Sonalhegde/TEAM_DISTRO/DRIVE LINKS/README.md

# 🔗 Team DISTRO - Official Google Drive Links

This folder contains direct access links to the official media, presentation, documentation, and video deliverables for the **Lam Research Challenge 3.0: Stage 2 Practical Engineering Challenge (Team ID: LRC-26-0528)**.

---

## 📌 Deliverable Links

| # | Resource | Description | Direct Google Drive Link |
|---|---|---|---|
| 1 | 📊 **Team DISTRO Presentation** | Final presentation slide deck covering system design, hydraulics, calibration, and automation results | [Open Presentation Deck](https://drive.google.com/file/d/10BZNDP2cnqSBqfE3b11lk_6qCRlyOtN2/view?usp=drive_link) |
| 2 | 📄 **Stage 2 Challenge PDF** | Full practical engineering challenge documentation and report | [Open PDF Document](https://drive.google.com/file/d/1mI3886kun4H3olHrglMHzYJjbUjEaSkm/view?usp=drive_link) |
| 3 | 🎥 **Rig Journey Video** | Comprehensive video showcasing the rig assembly, testing, Case 1 surge mitigation, and Case 2 flushing automation | [Watch Journey Video](https://drive.google.com/file/d/1YkWeLo3Ct3zWrAMsbKcDU-8LQFBE7EN8/view?usp=drive_link) |

---

### Direct URL Reference List:
- **Presentation:** `https://drive.google.com/file/d/10BZNDP2cnqSBqfE3b11lk_6qCRlyOtN2/view?usp=drive_link`
- **PDF Documentation:** `https://drive.google.com/file/d/1mI3886kun4H3olHrglMHzYJjbUjEaSkm/view?usp=drive_link`
- **Journey Video:** `https://drive.google.com/file/d/1YkWeLo3Ct3zWrAMsbKcDU-8LQFBE7EN8/view?usp=drive_link`
