Sonalhegde/TEAM_DISTRO/TEAM.md

# Team Information

This document lists the members, roles, departments, and project contributions for Team DISTRO.

## Team Identification

- Team Identifier: LRC-26-0528
- Team Name: Team DISTRO
- Competition: Lam Research Challenge 3.0, Stage 2
- Institution: Nitte (Deemed to be University) - NMAM Institute of Technology

## Problem Statement

Design, build, commission, and validate an automated small-scale fluid handling platform capable of:
1. **Case 1 (Closed-Loop Recirculation and Level Protection):**
   - Maintain closed-loop recirculation at a target flow rate of 3.0 L/min (50 mL/s).
   - Mitigate sump overflow automatically when external liquid is added.
2. **Case 2 (Line Flushing and Safe Shutdown):**
   - Isolate the primary process tank safely using a solenoid valve.
   - Flush the piping network using a dedicated 4.2 L flush reservoir with all three pumps running simultaneously.
   - Transition automatically to a secure OFF state upon flush volume exhaustion.

## Team Members and Contributions

| Name | Role | Department | USN | Email | GitHub | Contribution |
|---|---|---|---|---|---|---|
| **Sonal Hegde** | Team Leader | Department of ECE | NNM24AC050 | nnm24ac050@nmamit.in | [@Sonalhegde](https://github.com/Sonalhegde) | Coding and Documentation |
| **Pratham Amin** | Member | Department of Mechanical Engineering | NNM24ME084 | nnm24me084@nmamit.in | [@pratham885](https://github.com/pratham885) | Piping, 3D Printing, CAD, and Calibration |
| **Jostan Saldanha** | Member | Department of ECE | NNM25AC502 | nnm25ac502@nmamit.in | [@jostan-saldanha](https://github.com/jostan-saldanha) | Electrical and Coding |
| **Mohammed Araan** | Member | Department of CSE | NNM24CS142 | nnm24cs142@nmamit.in | [@Araan-Sheikh](https://github.com/Araan-Sheikh) | Video Editing and 3D Modelling |
