Sonalhegde/TEAM_DISTRO/media/smps_clamp_top.png

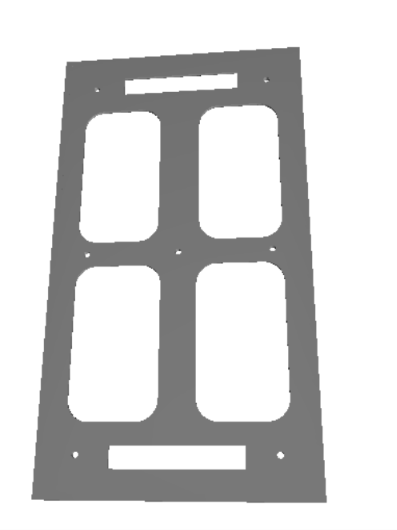
media/smps_clamp_top.png
