Sonalhegde/TEAM_DISTRO/cad/pcb-foot.stl

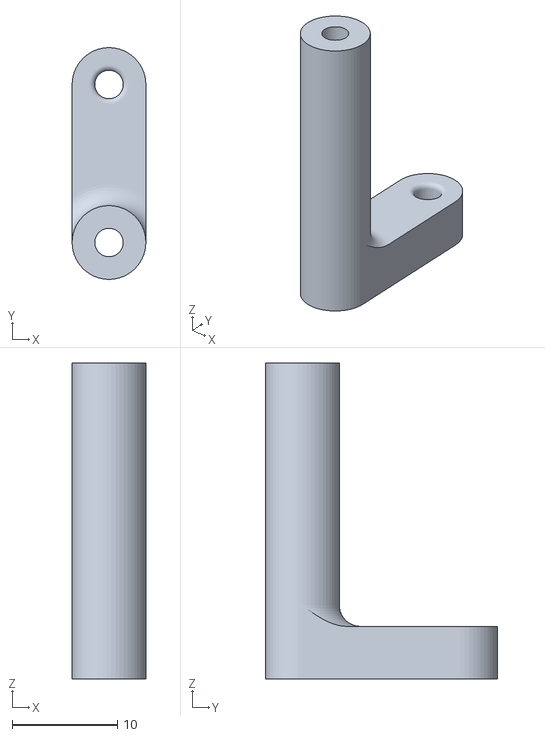
[picture p15: CAD file, 2026-10-14]
cad/pcb-foot.stl
7.00 x 22.0 x 30.0
