Sonalhegde/TEAM_DISTRO/hardware/3d-print/stl/smps-clamp.stl

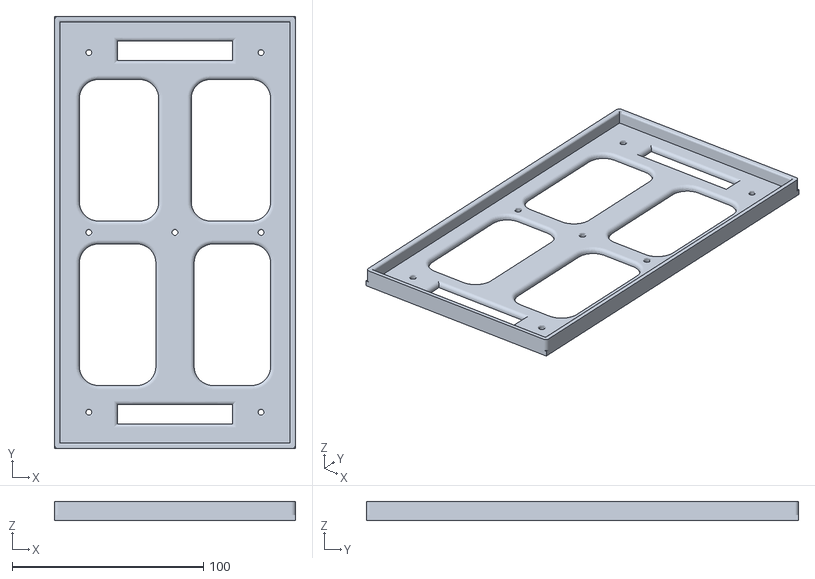
[picture p16: CAD file, 2026-10-13]
hardware/3d-print/stl/smps-clamp.stl
126.0 x 226.0 x 10.0
