Sonalhegde/TEAM_DISTRO/hardware/3d-print/stl/pipe-clamp.stl

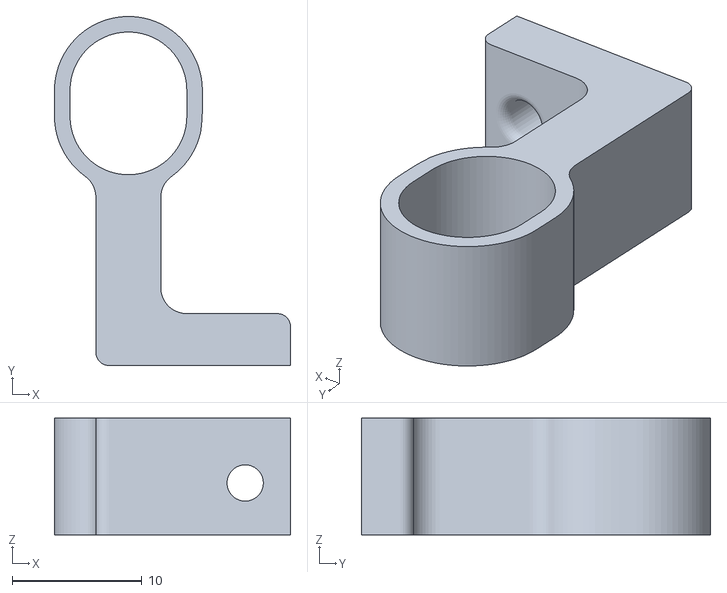
[picture p17: CAD file, 2026-10-13]
hardware/3d-print/stl/pipe-clamp.stl
18.2 x 26.9 x 9.00
