Sonalhegde/TEAM_DISTRO/hardware/3d-print/images/pcb_clamp_view2.png

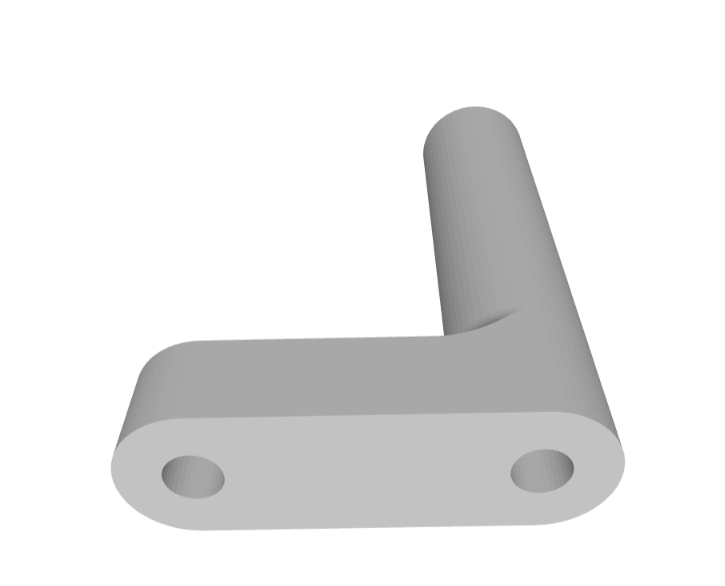
hardware/3d-print/images/pcb_clamp_view2.png
