Sonalhegde/TEAM_DISTRO/TESTING_PROCEDURE.md

# Lam Research Challenge 3.0: Stage 2 Testing Procedure
See the full, unabridged testing procedure manual at:
[COMPLETE_TESTING_PROCEDURE.md](docs/COMPLETE_TESTING_PROCEDURE.md)

This includes:
1. Pre-Test Physical Checklist & Fluid Initial Volumes
2. Case 1 Part A: Closed-Loop Recirculation & Sump Surge Interlock Test
3. Case 1 Part B: Ball Valve BV-01 Throttling (25%, 50%, 75%, 100%)
4. Case 2: Multi-Pump 4.2L Flush & Automated Depletion Shutdown
5. Master Pushbutton Start & Emergency Stop (E-Stop) Interlock
6. Serial CLI Diagnostic & Operational Command Reference
