Sonalhegde/TEAM_DISTRO/analysis/data/valve_characterization.csv

valve_pos_pct | pulse_freq_hz | flow_rate_Lpm
25 | 105.9 | 1.019
50 | 186.8 | 1.767
75 | 215.8 | 2.035
100 | 218.8 | 2.063
