Sonalhegde/TEAM_DISTRO/analysis/data/calibration_trials.csv

trial | pulses | time_s | volume_L | role
1 | 6678 | 30.584 | 1.040 | fit
2 | 5525 | 30.378 | 0.870 | fit
3 | 4316 | 30.777 | 0.700 | fit
4 | 2493 | 30.210 | 0.390 | fit
5 | 4881 | 30.571 | 0.790 | fit
6 | 6013 | 30.409 | 0.940 | fit
7 | 3542 | 30.279 | 0.560 | validation
