Sonalhegde/TEAM_DISTRO/assets/sensor_calibration_curve.png

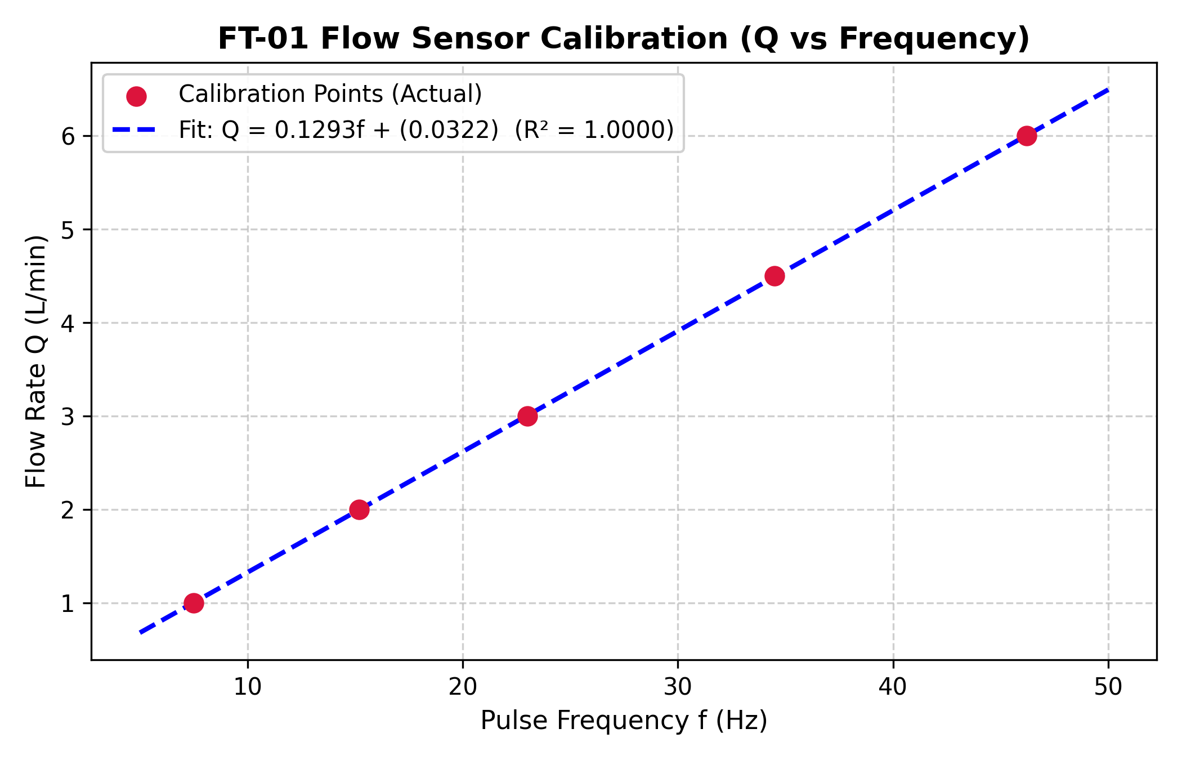
assets/sensor_calibration_curve.png
