Sonalhegde/TEAM_DISTRO/media/valve_characteristic_curve.png

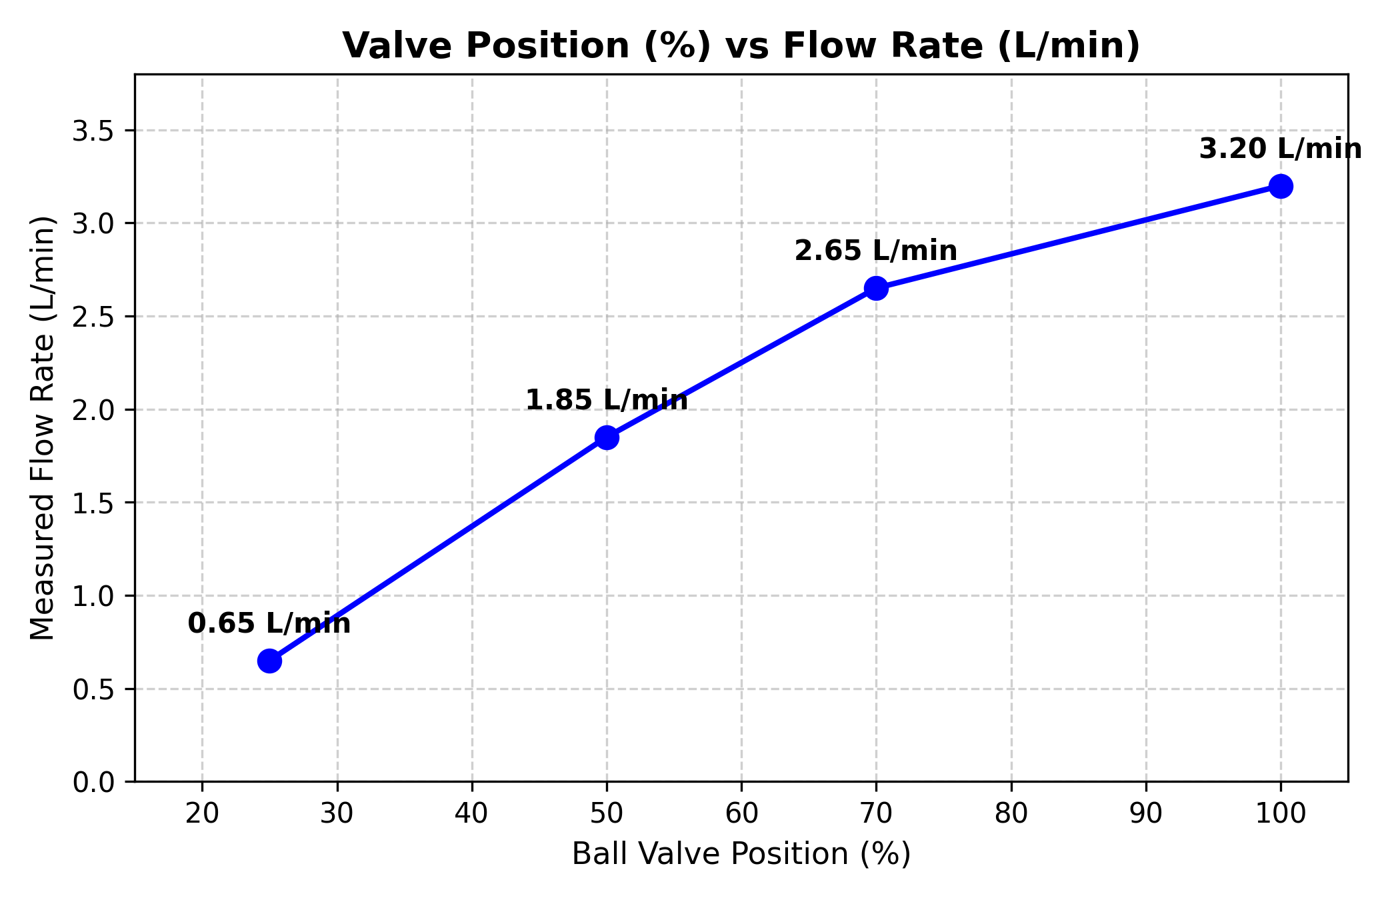
media/valve_characteristic_curve.png
