Sonalhegde/TEAM_DISTRO/(commit log)

2026-10-01 Add Lam Research Challenge 3.0 Stage 2 technical engineering package, P&ID diagrams, ESP32 firmware, telemetry tools, calibration regression, and comprehensive documentation
2026-10-01 Upgrade 3D digital twin with realistic models, real-time water flow streams, splash particles, and pump volute fluid swirl
2026-10-02 feat(test): add ESP32 full-capacity PWM pump test suite
2026-10-02 feat(firmware): add unverified full state-machine test sketch (Case 1 & Case 2)
2026-10-03 feat(firmware): migrate unverified controller to native Espressif C++ and add Serial Studio DAQ profile
    - Replace Arduino .ino sketch with modular native Espressif C++ (main/main.cpp)
    - Add ESP-IDF CMakeLists.txt and PlatformIO platformio.ini build configs
    - Stream real-time DAQ telemetry frames formatted for Serial Studio
    - Add telemetry/serial_studio_project.json dashboard project
    - Add repository .gitignore for build/cache directories
    - Update unverified/README.md with hardware pinout and operation details
    [main.cpp]
2026-10-12 feat(3dprint): add 3DPRINT folder with STL files, image collage, and clean master README
2026-10-12 chore(3dprint): keep only AutoCAD STL files and remove redundant copies
2026-10-13 feat(3dprint): add CAD dimension blueprints, geometric specifications, and 3D renders
2026-10-13 docs(hardware): update 3D printing documentation in STE format
2026-10-14 refactor: consolidate all documentation into single README.md, restructure CAD and batch scripts, and add MATLAB calibration figures
